MrHands-dev/ELEC5552-Team-2-06/README.md

# ELEC5552-Team-2-06
ELEC5552 Design Project Team 2-06 Repository

This is the required link for the project
