MrHands-dev/ELEC5552-Team-2-06/PCB DESIGN/PCB Schematics.pdf

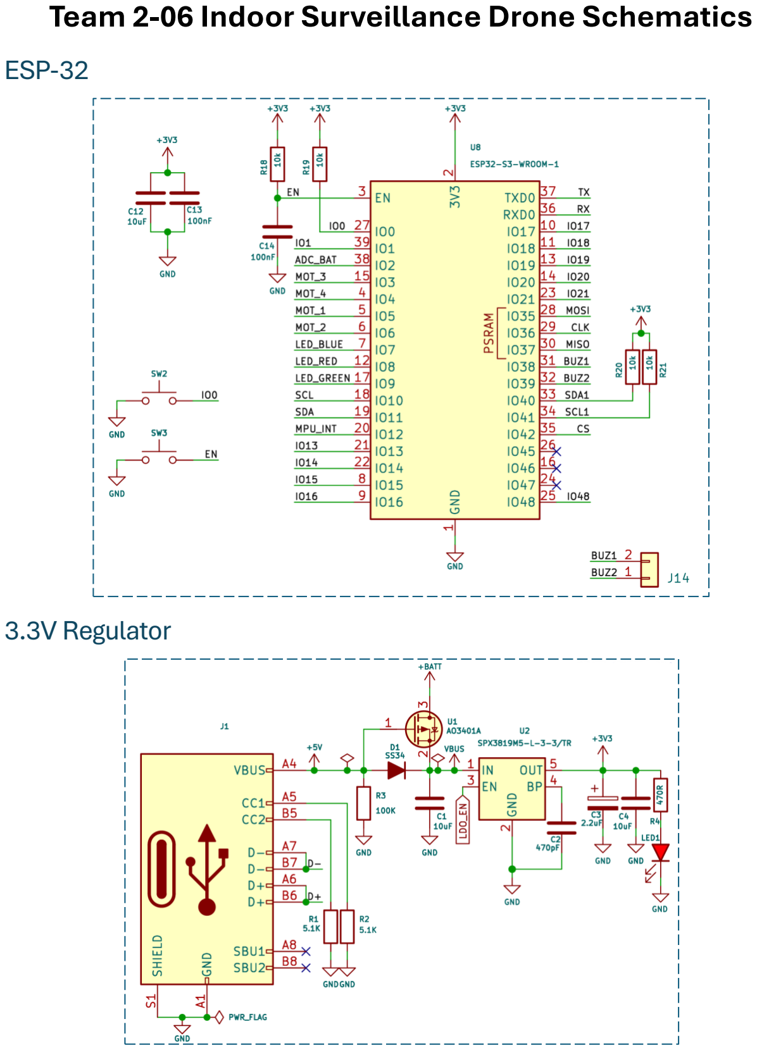
[picture p3: page 1]

Team 2-06 Indoor Surveillance Drone Schematics ESP-32

3.3V Regulator

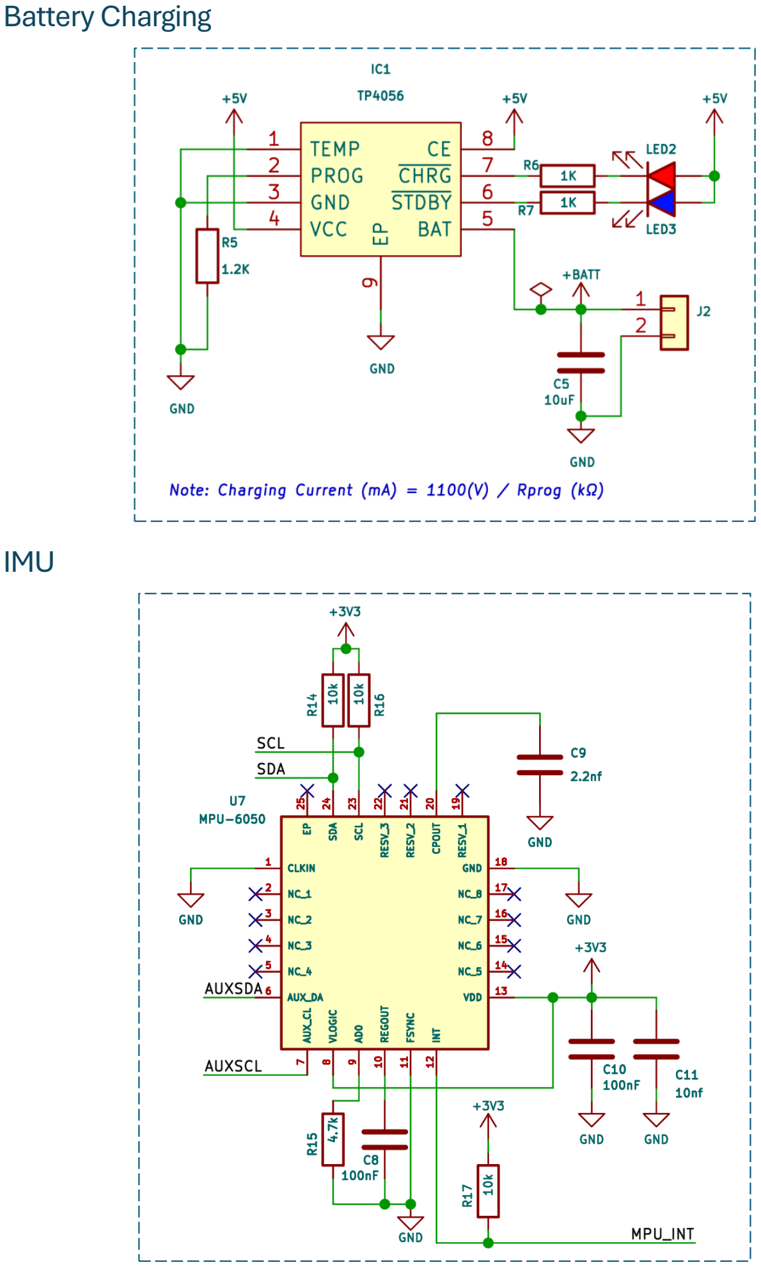
[picture p4: page 2]

Battery Charging

IMU

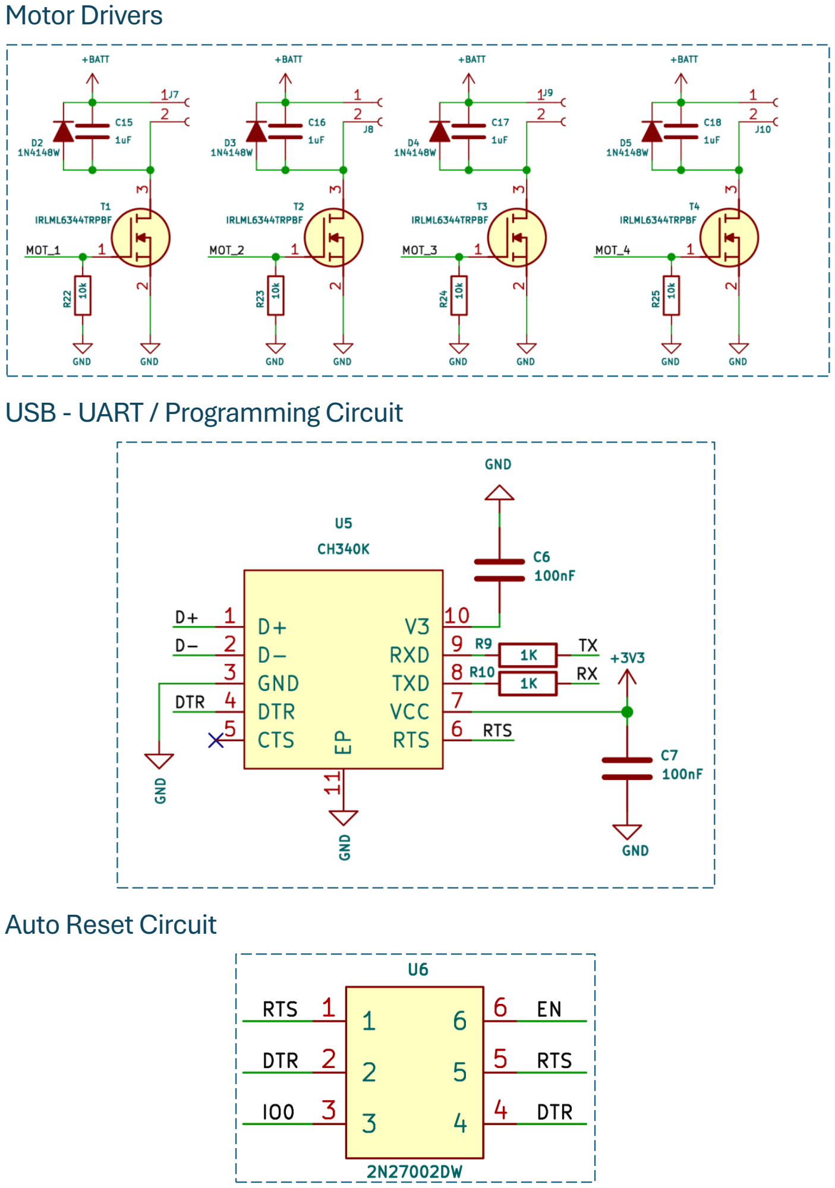
[picture p5: page 3]

Motor Drivers

USB - UART / Programming Circuit

Auto Reset Circuit

On/Off Circuit

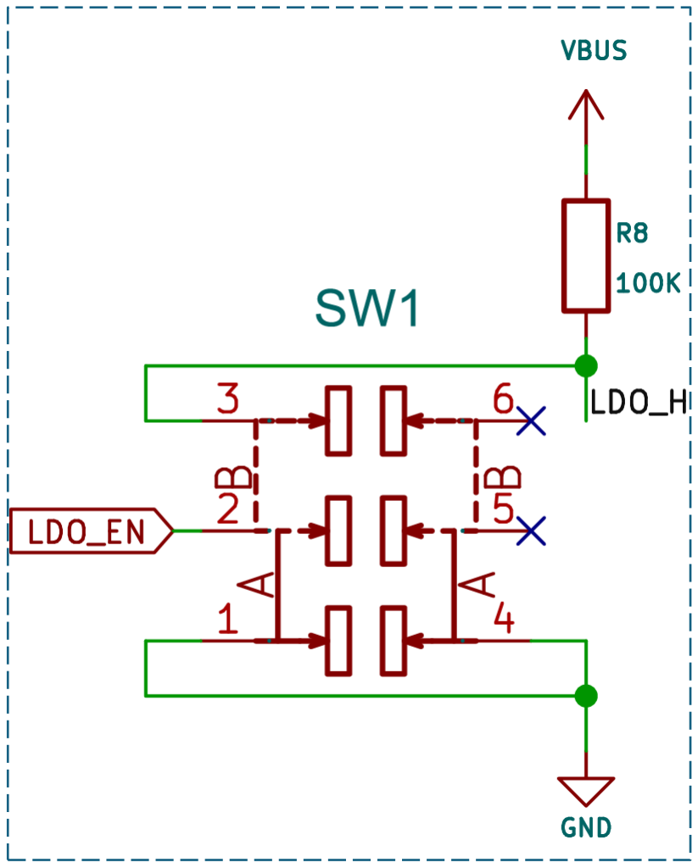
[picture p6: figure]

Battery Voltage Measurement

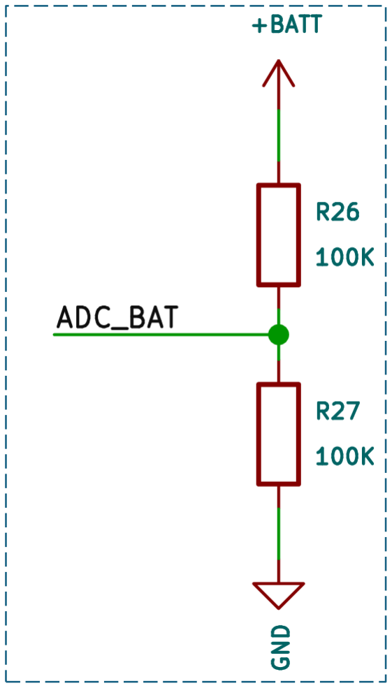
[picture p7: figure]
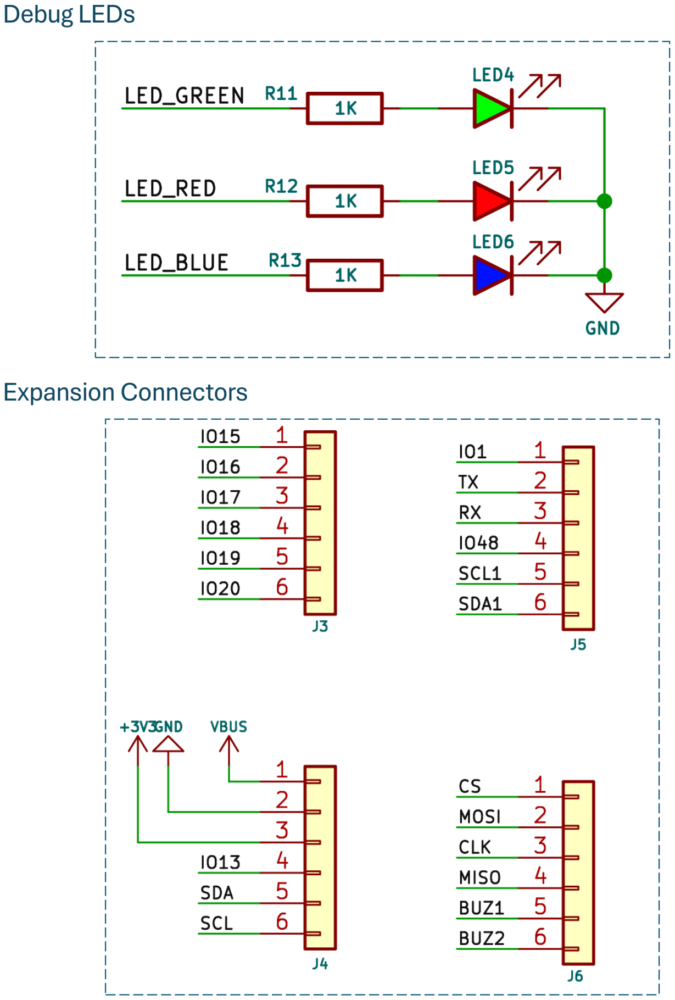
[picture p8: page 5]

Debug LEDs

Expansion Connectors

Auxiliary Modules (Sensors)

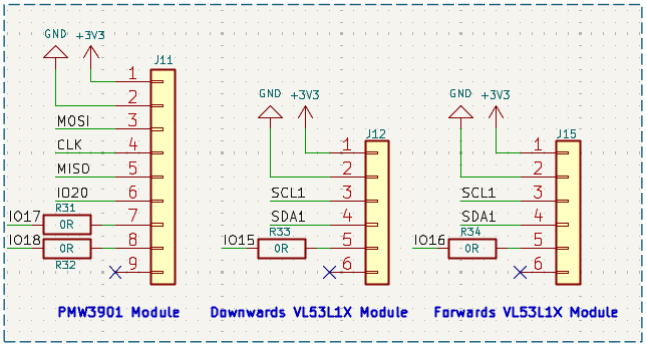
[picture p9: figure]

Camera and microSD Modules

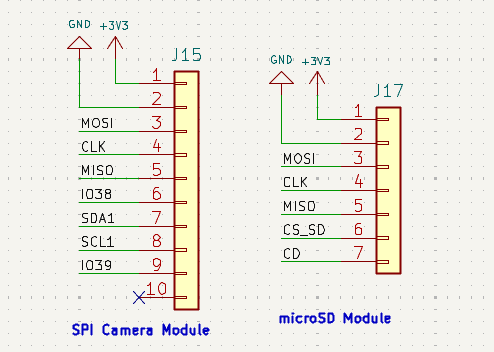
[picture p10: figure]
