MrHands-dev/ELEC5552-Team-2-06/Gallery/Gallery2/IMG_6558.jpg

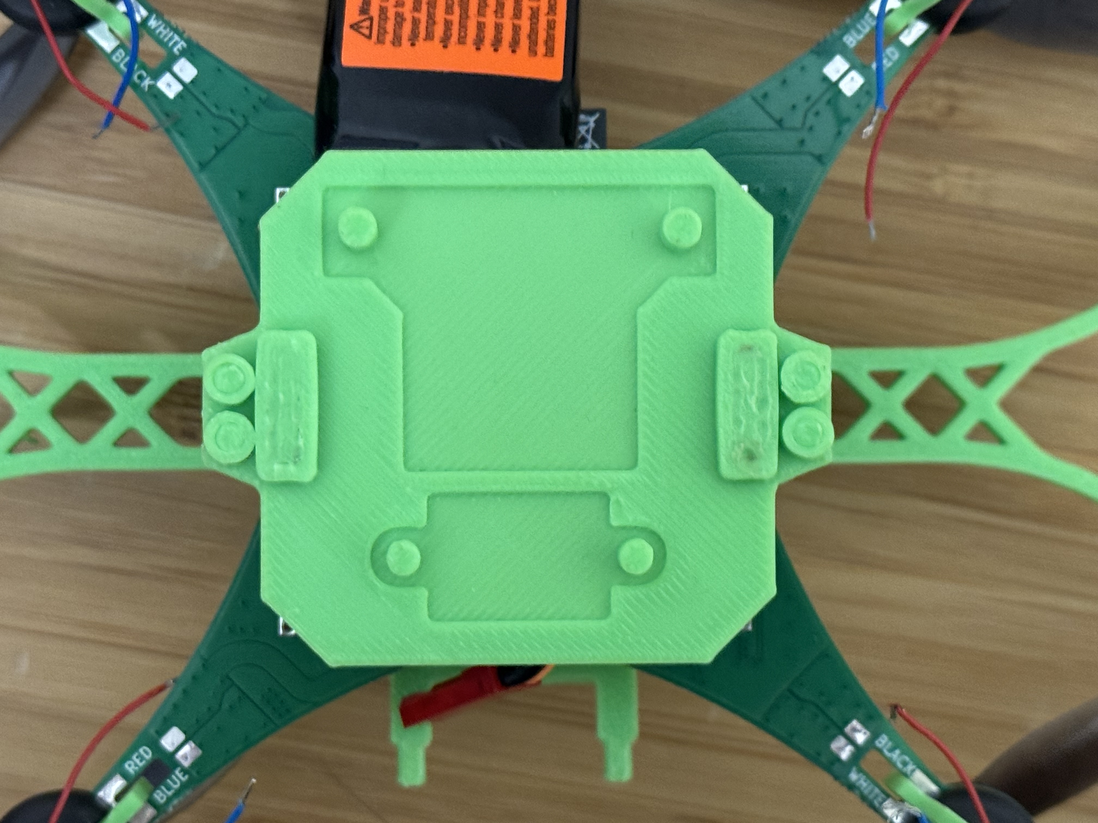
Gallery/Gallery2/IMG_6558.jpg
