MrHands-dev/ELEC5552-Team-2-06/Gallery/Gallery3/IMG_6574.jpg

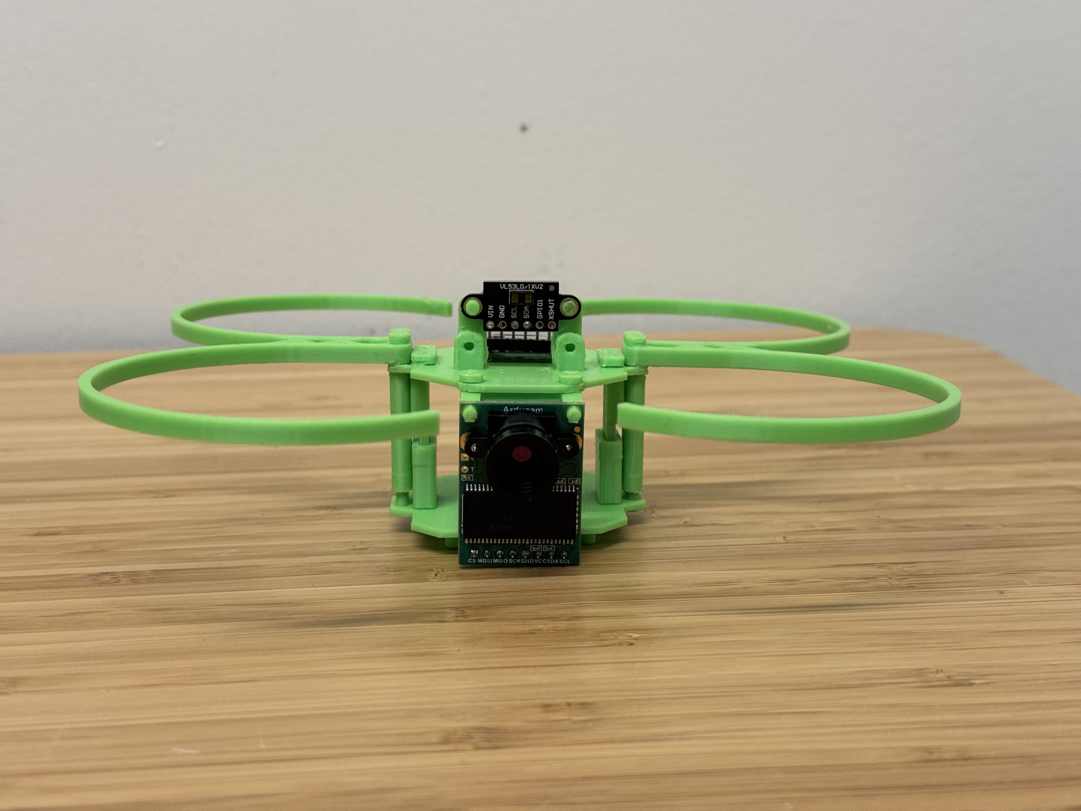
Gallery/Gallery3/IMG_6574.jpg
