MrHands-dev/ELEC5552-Team-2-06/Gallery/Gallery4/IMG_6585.jpg

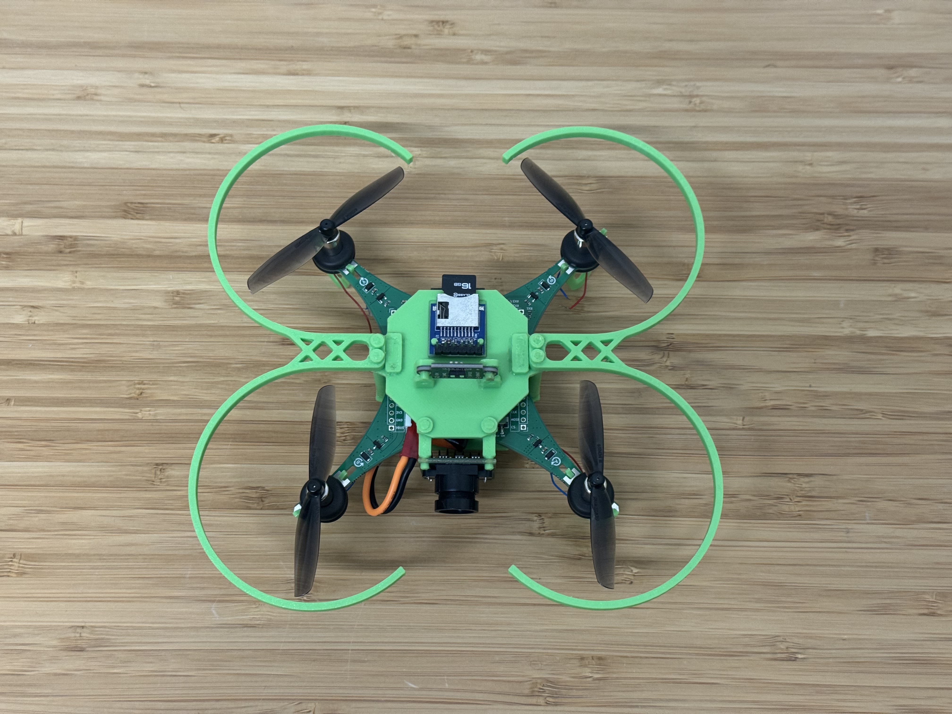
Gallery/Gallery4/IMG_6585.jpg
