MrHands-dev/ELEC5552-Team-2-06/Gallery/Gallery4/IMG_6588.jpg

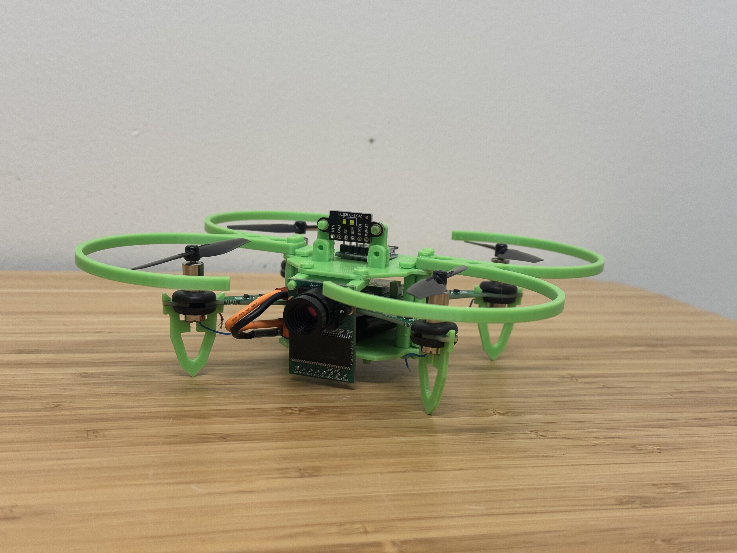
Gallery/Gallery4/IMG_6588.jpg
