MrHands-dev/ELEC5552-Team-2-06/Gallery/image-20250925-055927-82d2fa4e.jpeg

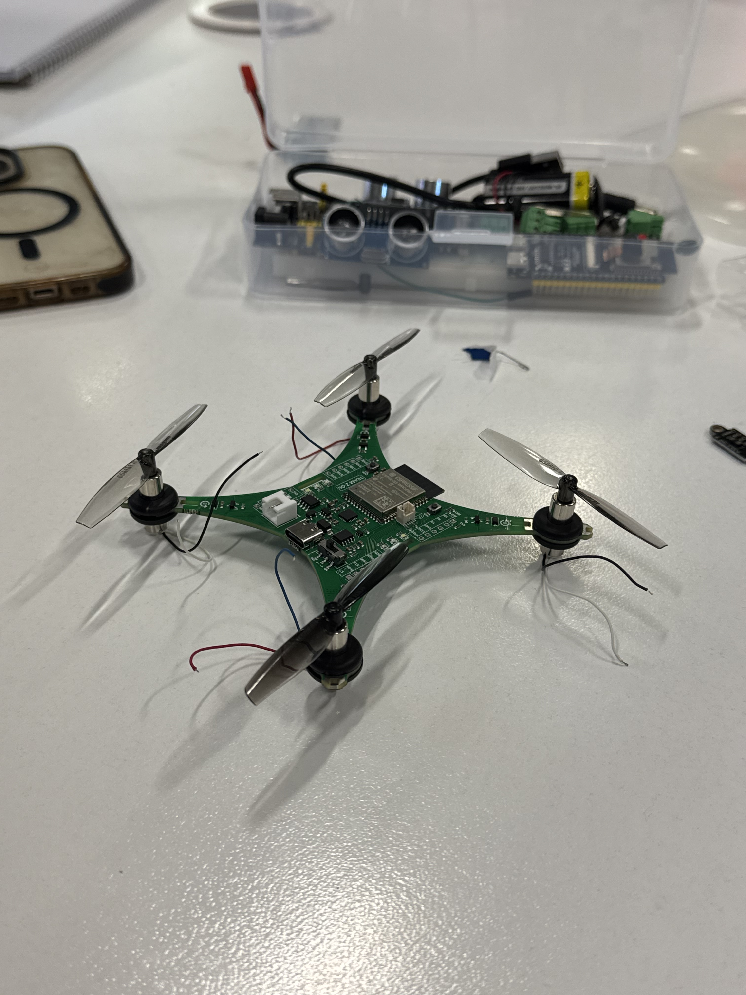
Gallery/image-20250925-055927-82d2fa4e.jpeg
