MrHands-dev/ELEC5552-Team-2-06/Gallery/image-20250925-063644-6a849998.jpeg

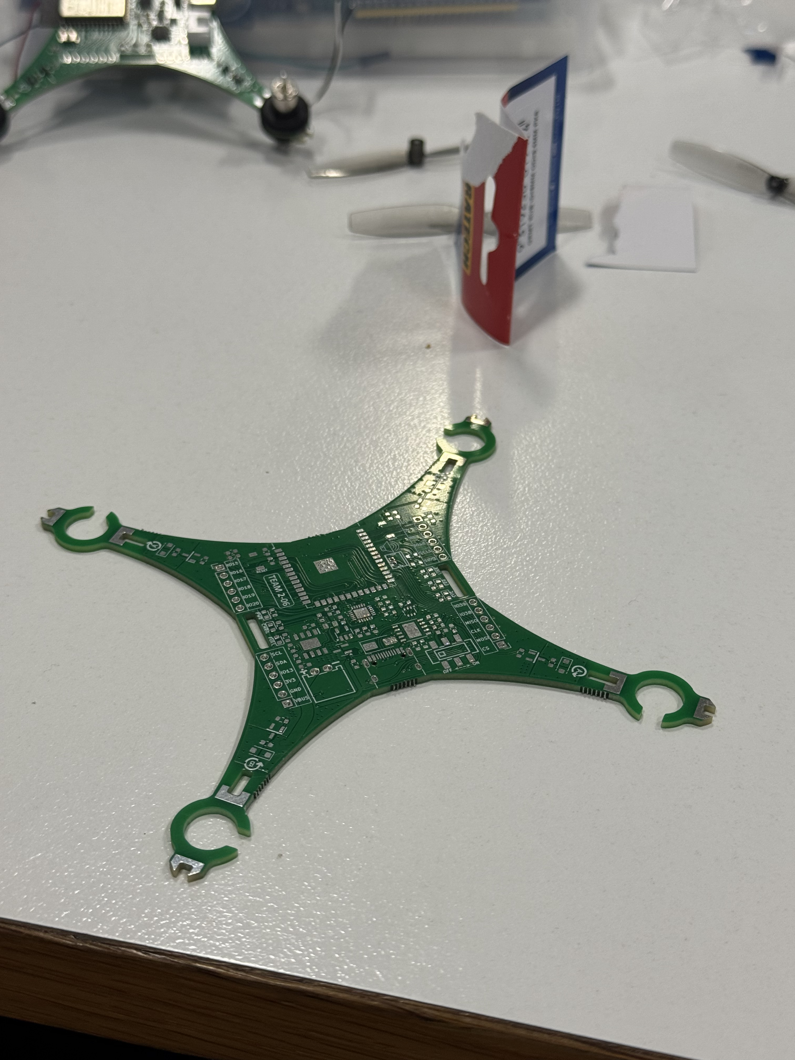
Gallery/image-20250925-063644-6a849998.jpeg
