MrHands-dev/ELEC5552-Team-2-06/Gallery/IMG_6534.jpg

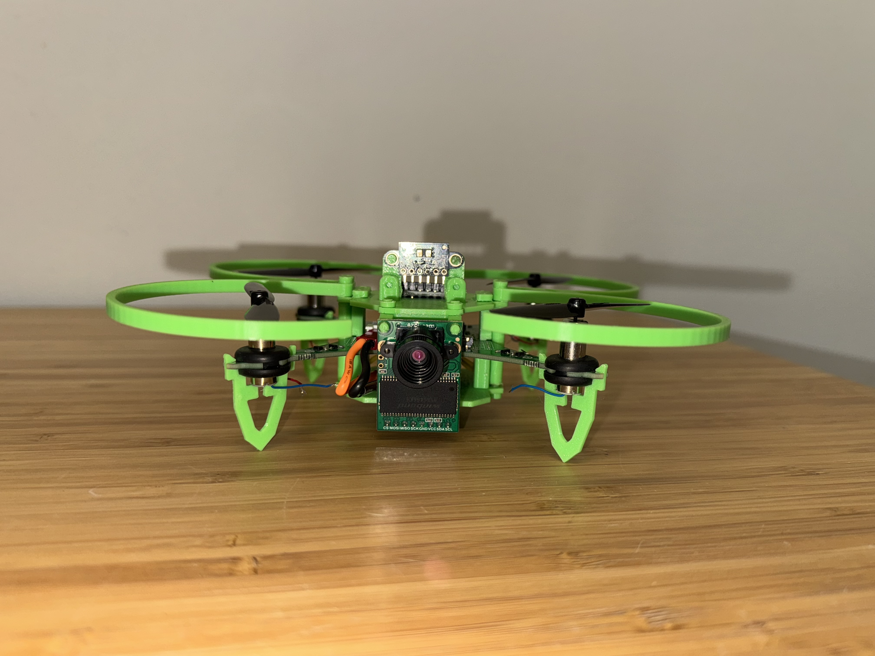
Gallery/IMG_6534.jpg
