MrHands-dev/ELEC5552-Team-2-06/Gallery/IMG_6539.jpg

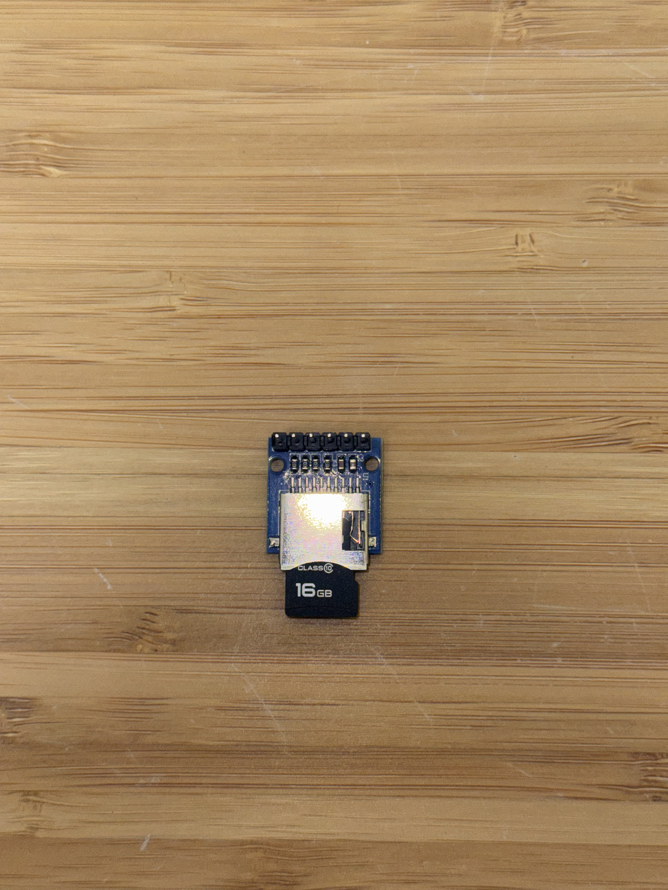
Gallery/IMG_6539.jpg
