MrHands-dev/ELEC5552-Team-2-06/3D CAD FILES/DroneTopLayer.stl

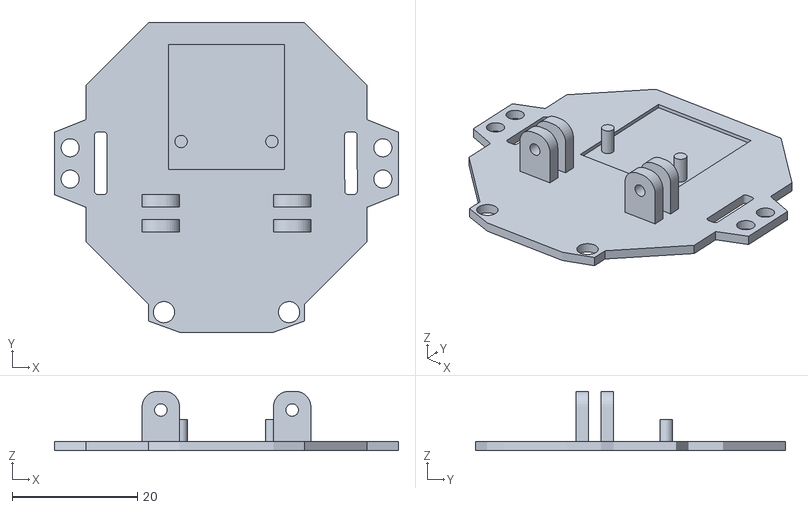
[picture p65: CAD file, 2025-10-28]
3D CAD FILES/DroneTopLayer.stl
55.0 x 49.5 x 9.50
