MrHands-dev/ELEC5552-Team-2-06/3D CAD FILES/DroneSupports.stl

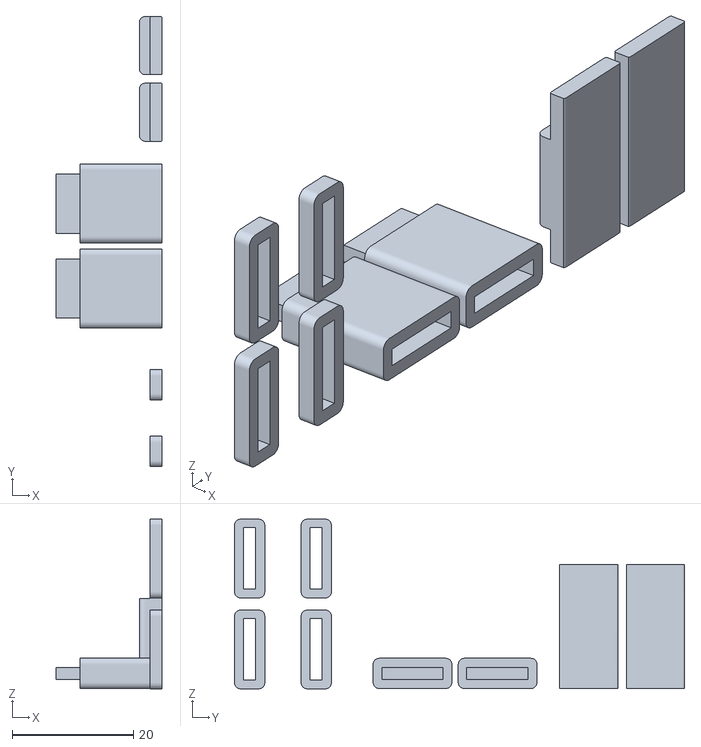
[picture p66: CAD file, 2025-10-28]
3D CAD FILES/DroneSupports.stl
17.6 x 74.3 x 28.0
