MrHands-dev/ELEC5552-Team-2-06/3D CAD FILES/DroneGuard (x2).stl

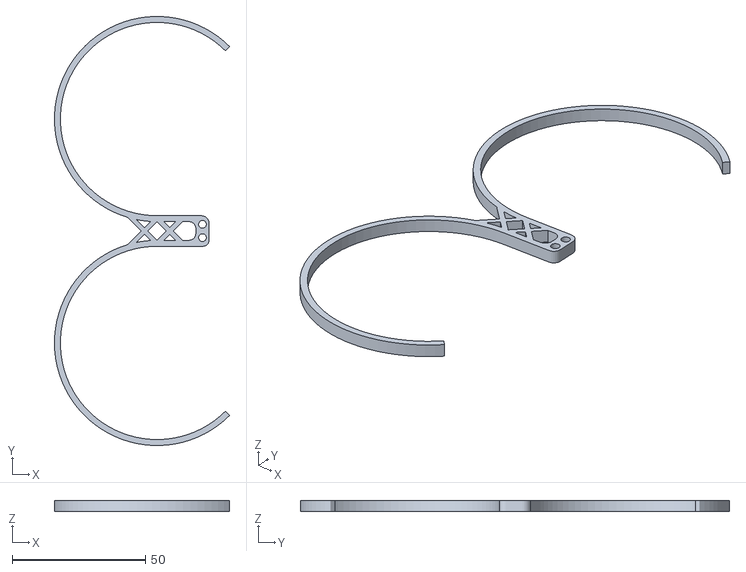
[picture p67: CAD file, 2025-10-28]
3D CAD FILES/DroneGuard (x2).stl
65.7 x 161.0 x 4.00
