MrHands-dev/ELEC5552-Team-2-06/3D CAD FILES/SidePeg.stl

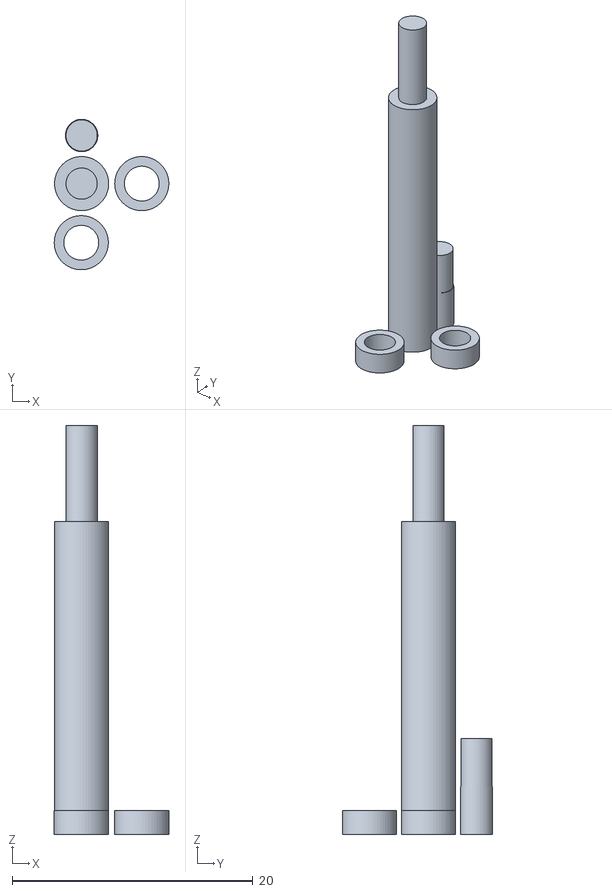
[picture p68: CAD file, 2025-10-28]
3D CAD FILES/SidePeg.stl
9.53 x 12.5 x 34.0
