MrHands-dev/ELEC5552-Team-2-06/3D CAD FILES/CamHolder2.stl

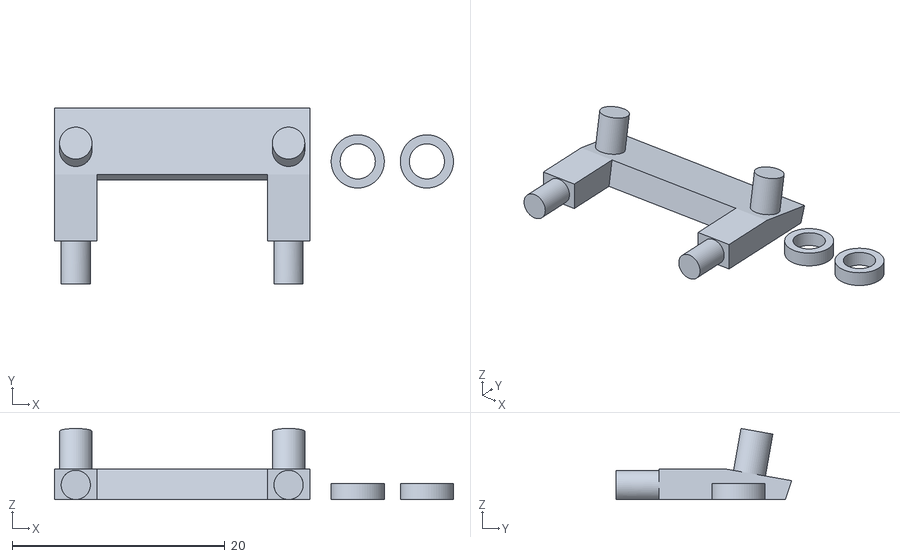
[picture p69: CAD file, 2025-10-28]
3D CAD FILES/CamHolder2.stl
37.5 x 16.5 x 6.68
