MrHands-dev/ELEC5552-Team-2-06/3D CAD FILES/ToF Legs.stl

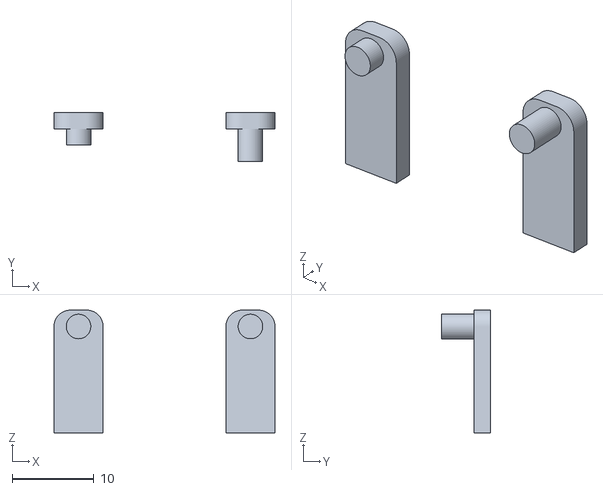
[picture p70: CAD file, 2025-10-28]
3D CAD FILES/ToF Legs.stl
27.0 x 6.00 x 15.0
