MrHands-dev/ELEC5552-Team-2-06/3D CAD FILES/Drone Leg2.stl

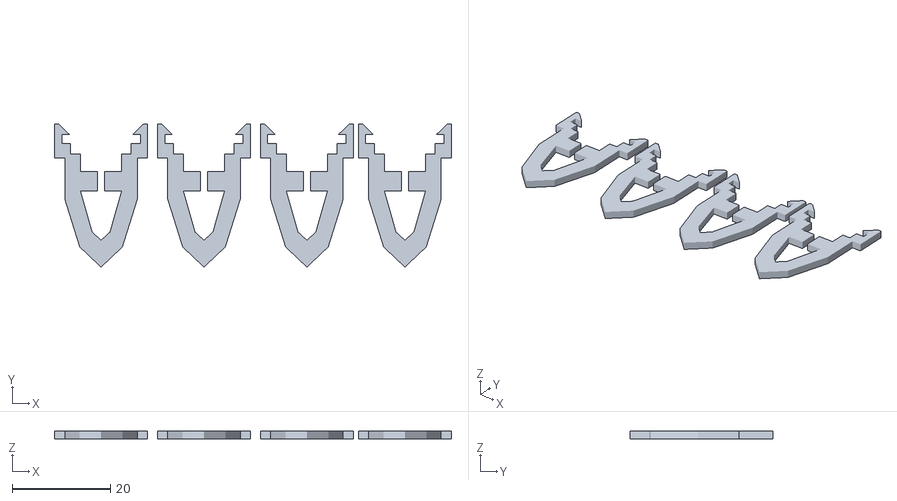
[picture p71: CAD file, 2025-10-28]
3D CAD FILES/Drone Leg2.stl
81.0 x 29.2 x 1.60
