MrHands-dev/ELEC5552-Team-2-06/3D CAD FILES/DroneBottomLayer.stl

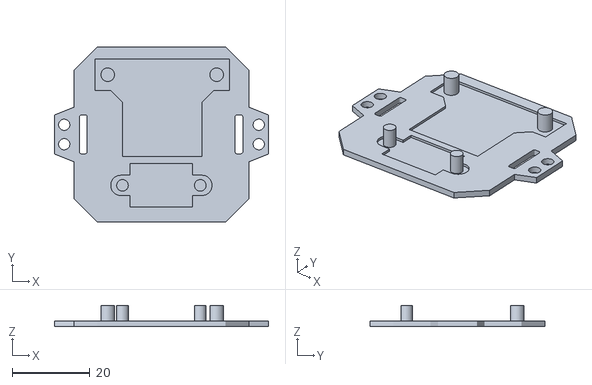
[picture p72: CAD file, 2025-10-28]
3D CAD FILES/DroneBottomLayer.stl
55.0 x 45.0 x 5.50
